JimeRivera/Proyect_SmartPlant/IMAGENES/IMÁGENES SMARTPLANT.pdf

IMÁGENES SMARTPLANT
Placa :

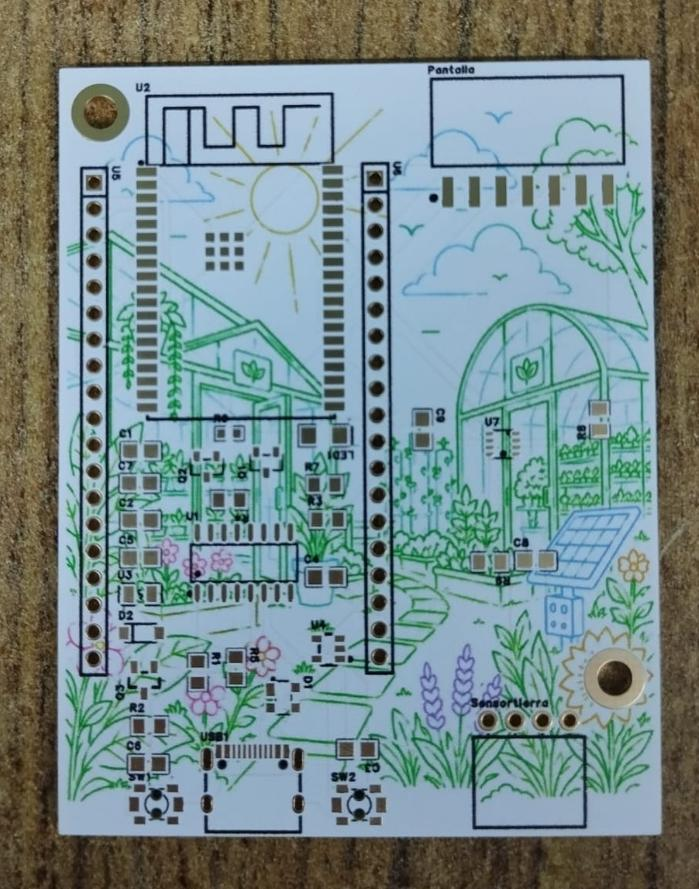
[picture p7: figure]

Soldadura :

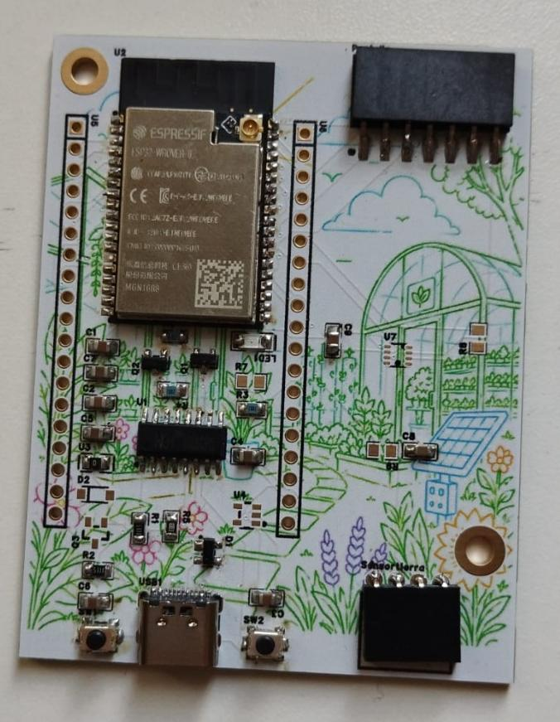
[picture p8: figure]
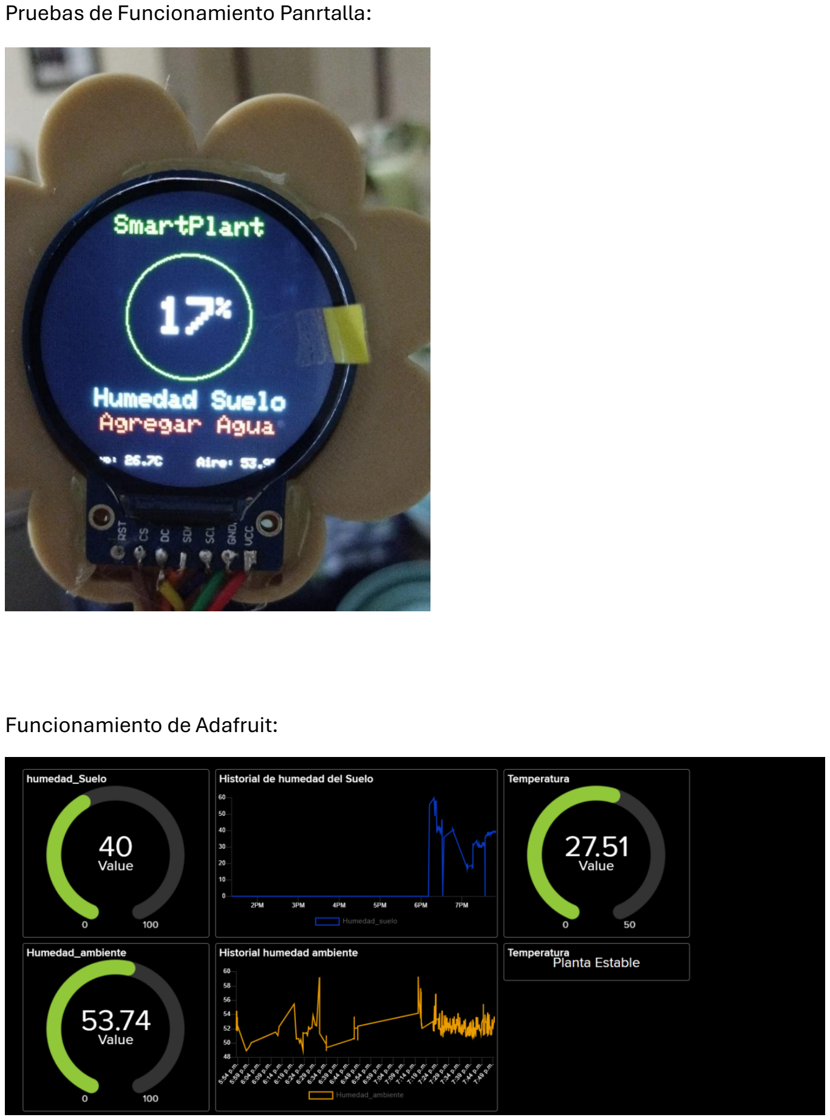
[picture p9: page 2]

Pruebas de Funcionamiento Panrtalla:

Funcionamiento de Adafruit:

Funcionamiento de sensor

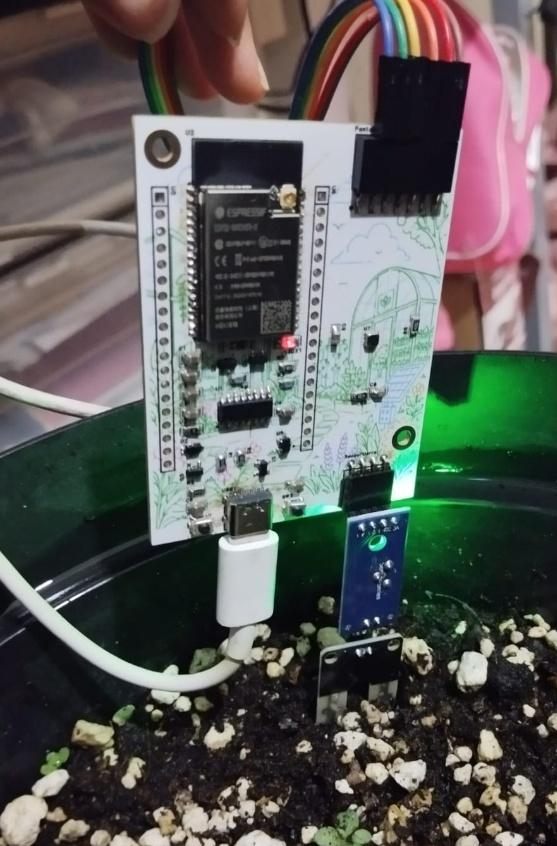
[picture p10: figure]

Pruebas de funcionamiento pantalla y sensor :

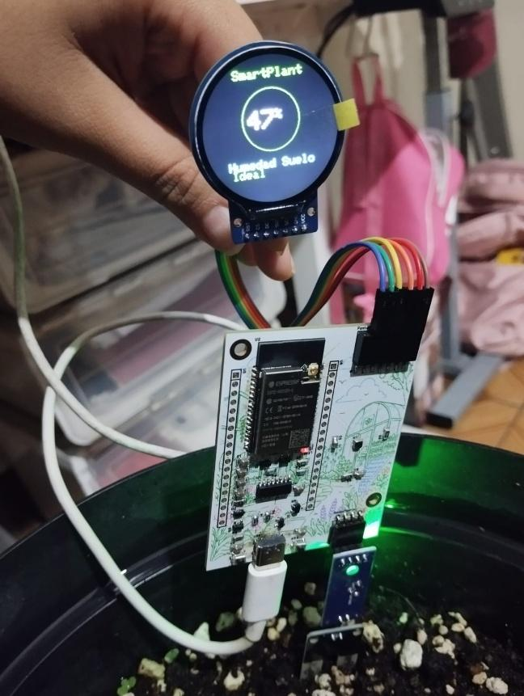
[picture p11: figure]
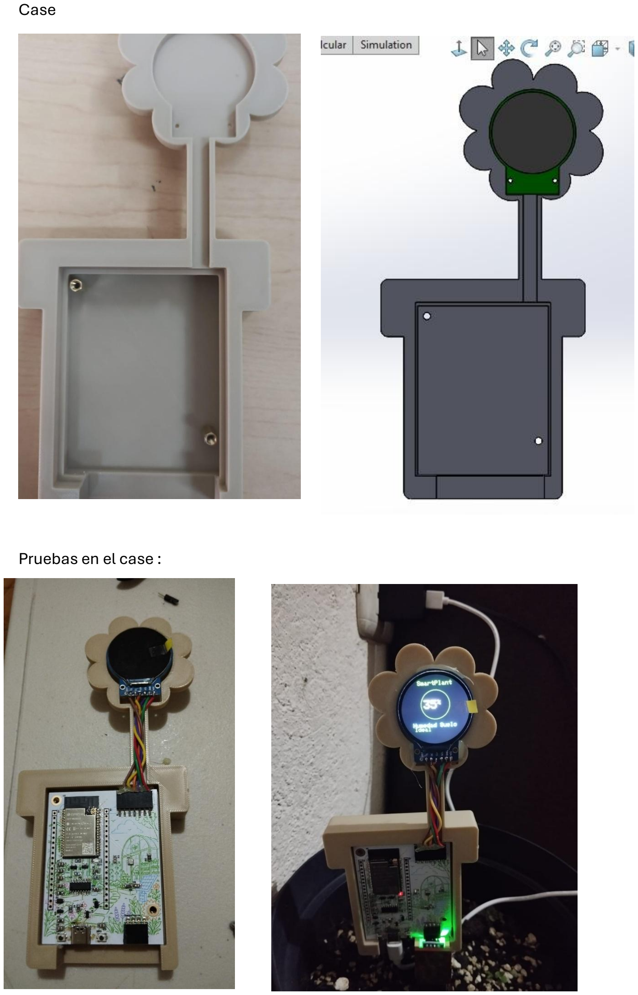
[picture p12: page 4]

Case

Pruebas en el case :

Parte final , pantalla diseño final

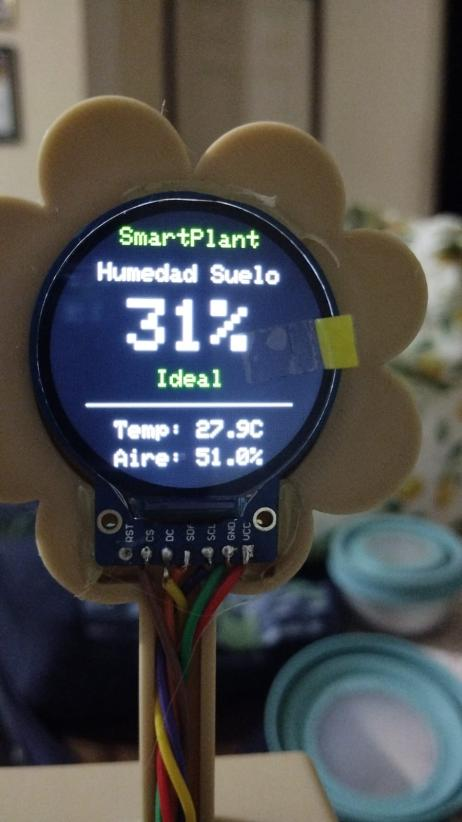
[picture p13: figure]
