JimeRivera/Proyect_SmartPlant/BOOM/BOM_Board1_Schematic1_2026-06-26 (1).xlsx

No. | Quantity | Comment | Designator | Footprint | Value | Manufacturer Part | Manufacturer | Supplier Part | Supplier
1 | 7 | 10uF | C1,C2,C3,C4,C5,C6,C7 | C0805 | 10uF | C0805X106K010T | IHHEC(禾伸堂) | C340314 | LCSC
2 | 1 | 100nF | C8 | C0805 | 100nF | C0805X104K101TB | IHHEC(禾伸堂) | C495959 | LCSC
3 | 1 | 1uF | C9 | C0805 | 1uF | NC0805B105K101CDDN | HUI JU(汇聚) | C19185643 | LCSC
4 | 1 | PRTR5V0U2X | D1 | SOT-143-4_L2.9-W1.3-P1.92-LS2.4-BL |  | PRTR5V0U2X | TECH PUBLIC(台舟) | C2827688 | LCSC
5 | 1 | MBR120LSFT1G | D2 | SOD-123_L2.8-W1.8-LS3.7-RD |  | MBR120LSFT1G | onsemi(安森美) | C891416 | LCSC
6 | 1 | YLED1206W | LED1 | LED1206-R-RD |  | YLED1206W | YONGYUTAI(永裕泰) | C28310437 | LCSC
7 | 1 | HX PM2.54-1x7P WT | Pantalla | HDR-SMD_7P-P2.54-H-F-W8.5 |  | HX PM2.54-1x7P WT | hanxia(韩下) | C46061771 | LCSC
8 | 2 | MMBT2222ALT1G | Q1,Q2 | SOT-23-3_L2.9-W1.3-P1.90-LS2.4-BR |  | MMBT2222ALT1G | onsemi(安森美) | C82460 | LCSC
9 | 1 | DMP2045U-7 | Q3 | SOT-23-3_L2.9-W1.3-P1.90-LS2.4-BR-CW |  | DMP2045U-7 | DIODES(美台) | C459541 | LCSC
10 | 2 | 5.1kΩ | R1,R2 | R0805 | 5.1kΩ | HoAR0805-1/8W-5.1KR-0.1%-TCR25 | Milliohm(毫欧) | C2912598 | LCSC
11 | 2 | 10kΩ | R3,R4 | R0805 | 10kΩ | SCR0805J10K | VO(翔胜) | C5140188 | LCSC
12 | 1 | 100kΩ | R5 | R0805 | 100kΩ | SCR0805J100K | VO(翔胜) | C3017875 | LCSC
13 | 1 | 10K | R6 | R0603 | 10K
14 | 1 | 80.6kΩ | R7 | R0805 | 80.6kΩ | CR0805F88062G | LIZ(丽智电子) | C101871 | LCSC
15 | 2 | 4.7kΩ | R8,R9 | R0805 | 4.7kΩ | RMC08054.7K1%N | Tyohm(幸亚电阻) | C269746 | LCSC
16 | 1 | DS1024-1x4R2 | Sensortierra | HDR-TH_4P-P2.54-H-F-W10.2 |  | DS1024-1x4R2 | CONNFLY | C7509597 | LCSC
17 | 2 | PTS820J25MSMTRLFS | SW1,SW2 | KEY-SMD_6P-L3.9-W2.9_PTS820 |  | PTS820J25MSMTRLFS | C&K | C221900 | LCSC
18 | 1 | CH340C | U1 | SOP-16_L10.0-W3.9-P1.27-LS6.0-BL |  | CH340C | WCH(南京沁恒) | C84681 | LCSC
19 | 1 | 2.4GHz | U2 | WIFI-SMD_ESP32-WROVER-E-N8R2 | 2.4GHz | ESP32-WROVER-IE-N16R8 | ESPRESSIF(乐鑫) | C701352 | LCSC
20 | 1 | 0805L100WR | U3 | F0805 |  | 0805L100WR | Littelfuse(美国力特) | C80270 | LCSC
21 | 1 | AP2112K-3.3TRG1 | U4 | SOT-23-5_L2.9-W1.6-P0.95-LS2.8-BR |  | AP2112K-3.3TRG1 | TECH PUBLIC(台舟) | C23380830 | LCSC
22 | 2 | PZ254-1-19-Z-8.5 | U5,U6 | HDR-TH_19P-P2.54-V-F |  | PZ254-1-19-Z-8.5 | HCTL(华灿天禄) | C3012221 | LCSC
23 | 1 | BME280 | U7 | LGA-8_BME280_BL |  | BME280 | Bosch(博世) | C92489 | LCSC
24 | 1 | U262-161N-4BVC11 | USB1 | USB-3.1-SMD_U262-161N-4BVC11 |  | U262-161N-4BVC11 | XKB Connection(中国星坤) | C319148 | LCSC
