JimeRivera/Proyect_SmartPlant/Hardware/SCH_Schematic1_2026-07-08.pdf

# DSR# 10 RI# 11 DCD# 12 DTR# 13 RTS# 14 R232 15 VCC 16

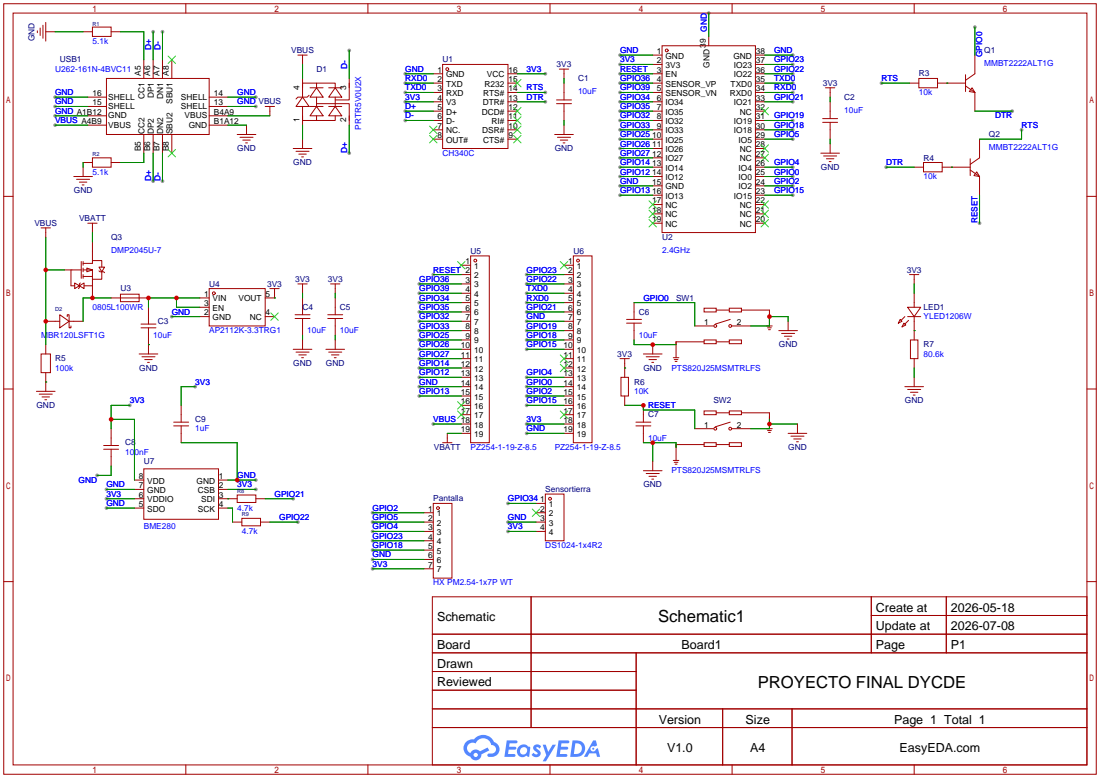
[picture p14: page 1]

Schematic | Schematic1 | Create at | 2026-05-18

Update at | 2026-07-08

Board | Board1 | Page | P1
Drawn | | PROYECTO FINAL DYCDE
Reviewed

Version | Size | Page 1 Total 1
V1.0 | A4 | EasyEDA.com
